joebmz98/FM-Drum-Machine/README.md

# FM-Drum-Machine
Teensy based frequency modulation drum machine. It uses the Audio Design tool to synthesize drum sounds and has a 16 step sequencer powered by an Arduino Nano.
