joebmz98/FM-Drum-Machine/docs/FM_DRUMMACHINE_LTSPICE/FM_DRUMMACHINE_COMPRESSOR_PEAKDETECTOR.asc

B1: bv; V=6 + 1.4*(time>0.05)*exp(-1*(time-0.05))*sin(2*pi*100*(time-0.05))
C1: EuropeanPolcap; 10µF
C2: cap; 10µF
C5: cap; 10µ; V=16 Irms=0 Rser=0.0038 Lser=877p mfg="Würth Elektronik" pn="885012108017 WCAP-CSGP 1206" type="X5R"
D7: diode; 1N4148
R1: res; 50k
R2: res; 500
R3: res; 50k
R4: res; 500
R6: res; 20k
R12: res; 1k
R13: res; 20k
R14: res; 80k
R15: res; 100k
R16: res; 100k
R17: res; 100k
R18: res; 100k
R19: res; 9k
R20: res; 1k
R21: res; 33k
R22: res; 470
R23: res; 4.7k
U1: UniversalOpAmp
U2: UniversalOpAmp
U6: UniversalOpAmp
U7: UniversalOpAmp
V1: signal; PWL file=decaying_sine_drum.txt
V3: voltage; 12V
Vref: voltage; 6
Named nets: 0
.tran 0 5s 0 100u
Vref
Vref
12V
THRESHOLD POT
.options pTranTau=0
PEAK DETECTOR
ATTACK POT
RATIO POT
REL POT
Vref
12V
Vref
