joebmz98/FM-Drum-Machine/docs/FM_DRUMMACHINE_LTSPICE/FM_DRUMMACHINE_COMPRESSOR.asc

B1: bv; V=6 + 1.4*(time>0.05)*exp(-1*(time-0.05))*sin(2*pi*100*(time-0.05))
C1: EuropeanPolcap; 10µF
C5: cap; 10µ; V=16 Irms=0 Rser=0.0038 Lser=877p mfg="Würth Elektronik" pn="885012108017 WCAP-CSGP 1206" type="X5R"
D1: diode; 1N4148
D2: diode; 1N4148
D3: diode; 1N4148
D4: diode; 1N4148
D5: diode; 1N4148
D6: diode; 1N4148
D7: diode; 1N4148
R1: res; 90k
R3: res; 10k
R4: res; 100K; tol=1 pwr=0.1
R5: res; 14k
R6: res; 20k
R7: res; 100k
R8: res; 100k
R9: res; 100k
R10: res; 100k
R11: res; 14k
R12: res; 1k
R13: res; 5k
R14: res; 80k
R15: res; 100k
R16: res; 100k
R17: res; 100k
R18: res; 100k
R19: res; 9k
R20: res; 1k
R21: res; 33k
R22: res; 470
R23: res; 4k7
U1: UniversalOpAmp
U2: UniversalOpAmp
U3: UniversalOpAmp
U4: UniversalOpAmp
U5: UniversalOpAmp
U6: UniversalOpAmp
U7: UniversalOpAmp
V1: signal; PWL file=decaying_sine_drum.txt
V3: voltage; 12V
Vref: voltage; 6
Named nets: 0
.tran 0 5s 0 100u
Vref
Vref
12V
THRESHOLD POT
.options pTranTau=0
PEAK DETECTOR
ATTACK POT
RATIO POT
REL POT
Vref
12V
Vref
