joebmz98/FM-Drum-Machine/build/FM_DRUM_MACHINE/FM_DRUM_MACHINE.kicad_pcb

## KiCad design build/FM_DRUM_MACHINE/FM_DRUM_MACHINE.kicad_pcb (2025-09-05)

Schematic: FM_DRUM_MACHINE.kicad_sch, FM Drum Machine

Parts:
A1, A2: GY-PCM5102; PCM5102_DAC_BreakoutBoard
C1, C2: 100uF; CP_Radial_D5.0mm_P2.00mm
C3, C4, C5, C6: 10uF; CP_Radial_D5.0mm_P2.00mm
C27, C43, C44, C45, C46, C47, C48, C49, C50, C51, C52, C53, C54, C55, C56, C57, C58, C59, C60, C61, C62, C63, C64, C75, C77, C79, C80: 10nF; C_Disc_P5.08mm
C69, C70, C71, C72, C73, C82: 10uF; C_Disc_P5.08mm
C74, C76, C78, C81: 1uF; C_Disc_P5.08mm
C83, C84, C85, C86, C87: 10Uf; C_Disc_P5.08mm
D1: 1N4148; D_4148_BigPads
D2: LED_STEP1; LED_D5.0mm
D3, D4: RED LED; LED_D5.0mm
D5, D6, D7, D8, D9, D10, D11, D12, D13, D14, D15, D16, D17, D18, D19, D20, D21, D22, D23, D24, D25, D26, D27, D28, D29, D63, D65, D66: 1N4148; D_DO-35_P7.62mm_Horizontal
D30: LED_STEP2; LED_D5.0mm
D31: LED_STEP3; LED_D5.0mm
D32: LED_STEP4; LED_D5.0mm
D33: LED_STEP5; LED_D5.0mm
D34: LED_STEP6; LED_D5.0mm
D35: LED_STEP7; LED_D5.0mm
D36: LED_STEP8; LED_D5.0mm
D37: LED_STEP9; LED_D5.0mm
D38: LED_STEP10; LED_D5.0mm
D39: LED_STEP11; LED_D5.0mm
D40: LED_STEP12; LED_D5.0mm
D41: LED_STEP13; LED_D5.0mm
D42: LED_STEP14; LED_D5.0mm
D43: LED_STEP15; LED_D5.0mm
D44: LED_STEP16; LED_D5.0mm
D45: LED_KICK; LED_D5.0mm
D46: LED_SNARE; LED_D5.0mm
D47: LED_CHAT; LED_D5.0mm
D48: LED_OHAT; LED_D5.0mm
D49: LED_LOTOM; LED_D5.0mm
D50: LED_HITOM; LED_D5.0mm
D51: LED_PLAY/TEMPO; LED_D5.0mm
D52: LED_RECORD; LED_D5.0mm
D53: LED_EXTCLK; LED_D5.0mm
D54: 1N914BWS; D_4148_BigPads; Part Number 1N914BWS; JLCPCB ID C258181
D57, D58, D59, D60, D61, D62, D67: 1N4148; D_DO-35_SOD27_P5.08mm_Vertical_KathodeUp
J1: PJ-102A; CUI_PJ-102A
J2: KICK_BUFFEREDOUT; Jack_3.5mm_CUI_SJ1-3525N_Horizontal_edit
J3: SNARE_BUFFEREDOUT; Jack_3.5mm_CUI_SJ1-3525N_Horizontal_edit
J4: HATS_BUFFEREDOUT; Jack_3.5mm_CUI_SJ1-3525N_Horizontal_edit
J5: TOMS_BUFFEREDOUT; Jack_3.5mm_CUI_SJ1-3525N_Horizontal_edit
J6: LINE_OUT; Jack_3.5mm_CUI_SJ1-3525N_Horizontal_edit
Nano1: Arduino Nano; Arduino_Nano
R1, R3, R5, R13: 820R; R_Axial_DIN0207_L6.3mm_D2.5mm_P7.62mm_Horizontal
R2, R4, R6, R14, R15, R50: 330R; R_Axial_DIN0207_L6.3mm_D2.5mm_P7.62mm_Horizontal
R7, R8, R9, R10, R92, R93, R94, R95: 220R; R_Axial_DIN0207_L6.3mm_D2.5mm_P7.62mm_Horizontal
R11, R57, R58, R63, R64, R65, R66, R67, R68, R69: 10k; R_Axial_DIN0207_L6.3mm_D2.5mm_P7.62mm_Horizontal
R12, R51: 22k; R_Axial_DIN0207_L6.3mm_D2.5mm_P7.62mm_Horizontal
R38, R39, R40, R41, R44, R45, R46, R54, R61, R70, R71, R75, R77, R78, R80, R81, R83, R84, R85, R86, R87: 100k; R_Axial_DIN0207_L6.3mm_D2.5mm_P7.62mm_Horizontal
R52: 680R; R_Axial_DIN0207_L6.3mm_D2.5mm_P7.62mm_Horizontal
R53, R56, R60, R73: 220k; R_Axial_DIN0207_L6.3mm_D2.5mm_P7.62mm_Horizontal
R55, R62, R88: 33k; R_Axial_DIN0207_L6.3mm_D2.5mm_P7.62mm_Horizontal
R59, R74: 1M; R_Axial_DIN0207_L6.3mm_D2.5mm_P7.62mm_Horizontal
R76, R79: 14k; R_Axial_DIN0207_L6.3mm_D2.5mm_P7.62mm_Horizontal
R82: 2k; R_Axial_DIN0207_L6.3mm_D2.5mm_P7.62mm_Horizontal
R89: 4k7; R_Axial_DIN0207_L6.3mm_D2.5mm_P7.62mm_Horizontal
R91: 100R; R_Axial_DIN0207_L6.3mm_D2.5mm_P7.62mm_Horizontal
RV1: KICK_DECAY; Potentiometer_RV09_BigPads
RV2: SWING; Potentiometer_RV09_BigPads
RV3: KICK_TUNE; Potentiometer_RV09_BigPads
RV4: KICK_PUNCH; Potentiometer_RV09_BigPads
RV5: KICK_ATTACK; Potentiometer_RV09_BigPads
RV6: SNARE_DECAY; Potentiometer_RV09_BigPads
RV7, RV9: SNARE_SNAP; Potentiometer_RV09_BigPads
RV8: SNARE_PITCH; Potentiometer_RV09_BigPads
RV10: SNARE_TONE; Potentiometer_RV09_BigPads
RV11: HAT_DECAY; Potentiometer_RV09_BigPads
RV12: HAT_TIMBRE; Potentiometer_RV09_BigPads
RV13: HAT_TONE; Potentiometer_RV09_BigPads
RV14: HAT_RESONANCE; Potentiometer_RV09_BigPads
RV15: LOTOM_DECAY; Potentiometer_RV09_BigPads
RV16: LOTOM_PUNCH; Potentiometer_RV09_BigPads
RV17: LOTOM_TUNE; Potentiometer_RV09_BigPads
RV18: LOTOM_ATTACK; Potentiometer_RV09_BigPads
RV19: HITOM_DECAY; Potentiometer_RV09_BigPads
RV20: HITOM_PUNCH; Potentiometer_RV09_BigPads
RV21: HITOM_TUNE; Potentiometer_RV09_BigPads
RV22: HITOM_ATTACK; Potentiometer_RV09_BigPads
RV27, RV28: 100k; Potentiometer_Alps_RK09L_Double_Vertical
RV29, RV32: 100k; Potentiometer_RV09_BigPads
RV30: A100k; Potentiometer_RV09_BigPads
RV31: 10k; Potentiometer_RV09_BigPads
RV33, RV35, RV40, RV46: B100k; Potentiometer_RV09_BigPads
RV37: TEMPO; Potentiometer_RV09_BigPads
RV38: B20k; Potentiometer_RV09_BigPads
RV39: A1k; Potentiometer_RV09_BigPads
SW1: STEP1; SW_Cherry_MX_PCB_1.00u
SW2: STEP2; SW_Cherry_MX_PCB_1.00u
SW3: STEP3; SW_Cherry_MX_PCB_1.00u
SW4: STEP4; SW_Cherry_MX_PCB_1.00u
SW5: STEP5; SW_Cherry_MX_PCB_1.00u
SW6: STEP6; SW_Cherry_MX_PCB_1.00u
SW7: STEP7; SW_Cherry_MX_PCB_1.00u
SW8: STEP8; SW_Cherry_MX_PCB_1.00u
SW9: STEP9; SW_Cherry_MX_PCB_1.00u
SW10: STEP10; SW_Cherry_MX_PCB_1.00u
SW11: STEP11; SW_Cherry_MX_PCB_1.00u
SW12: STEP12; SW_Cherry_MX_PCB_1.00u
SW13: STEP13; SW_Cherry_MX_PCB_1.00u
SW14: STEP14; SW_Cherry_MX_PCB_1.00u
SW15: STEP15; SW_Cherry_MX_PCB_1.00u
SW16: STEP16; SW_Cherry_MX_PCB_1.00u
SW17: KICK_TRIG; SW_Cherry_MX_PCB_1.00u
SW18: SNARE_TRIG; SW_Cherry_MX_PCB_1.00u
SW19: CHAT_TRIG; SW_Cherry_MX_PCB_1.00u
SW20: OHAT_TRIG; SW_Cherry_MX_PCB_1.00u
SW21: LOTOM_TRIG; SW_Cherry_MX_PCB_1.00u
SW22: HITOM_TRIG; SW_Cherry_MX_PCB_1.00u
SW23: PLAY/PAUSE; SW_Cherry_MX_PCB_1.00u
SW24: RECORD; SW_Cherry_MX_PCB_1.00u
SW25: SELECT; SW_Cherry_MX_PCB_1.00u
SW26, SW27: SW_DPDT_x2; Switch_Toggle_DPDT_SubMini
TRIM1, TRIM2, TRIM3: TrimPot_T73YEt_100k; Potentiometer_Bourns_3296W_Vertical_BigPads; Part Number T73YE104KT20
TRS_JACK_1: MIDI IN TYPE A; Jack_3.5mm_CUI_SJ1-3525N_Horizontal_edit
TRS_JACK_2: MIDI THRU TYPE A; Jack_3.5mm_CUI_SJ1-3525N_Horizontal_edit
TRS_JACK_3: MIDI OUT TYPE A; Jack_3.5mm_CUI_SJ1-3525N_Horizontal_edit
Teensy4.0: Teensy4.0; Teensy40
U1: 6N138; DIP-8_W7.62mm_LongPads
U2: TL072; DIP-8_W7.62mm_LongPads; JLCPCB ID C90748
U3, U12: OPA551P; DIP-8_W7.62mm
U4, U10, U11, U13, U14: TL074; DIP-14_W7.62mm_LongPads
U5: MAX7221xNG; DIP-24_W7.62mm
U6, U7: CD74HC4067M; SOIC-24W_7.5x15.4mm_P1.27mm
U8: AMS1117-5.0; SOT-223-3_TabPin2
U9: AMS1117-3.3; SOT-223-3_TabPin2

Connections:
3.3V: A1.6 (VIN), A1.13 (XSMT), A2.6 (VIN), A2.13 (XSMT), C72.2, RV1.3, RV3.3, RV4.3, RV5.3, RV6.3, RV7.3, RV8.3, RV9.3, RV10.3, RV11.3, RV12.3, RV13.3, RV14.3, RV15.3, RV16.3, RV17.3, RV18.3, RV19.3, RV20.3, RV21.3, RV22.3, U9.2 (VO)
5V: C70.2, C71.2, Nano1.30 (VIN), R8.2, R10.2, R11.2, RV2.3, RV37.3, Teensy4.0.33 (VIN), U1.8 (VCC), U5.19 (V+), U6.24 (VCC), U7.24 (VCC), U8.2 (VO), U9.3 (VI)
12V: C1.1, D54.2 (A), J1.2, J1.3, R70.1, R88.1, U2.8 (V+), U3.7 (V+), U4.4 (V+), U10.4 (V+), U11.4 (V+), U12.7 (V+), U13.4 (V+), U14.4 (V+)
A1BCK: A1.2 (BCK), A2.2 (BCK), Teensy4.0.28 (21_A7_RX5_BCLK1)
A1DIN: A1.3 (DIN), A2.3 (DIN), Teensy4.0.9 (7_RX2_OUT1A)
A1LCK: A1.4 (LCK), A2.4 (LCK), Teensy4.0.27 (20_A6_TX5_LRCLK1)
A1SCK: A1.1 (SCK), A2.1 (SCK), Teensy4.0.30 (23_A9_CRX1_MCLK1)
AGND: A1.8 (AGND), A1.10 (AGND), A2.8 (AGND), A2.10 (AGND)
CLK: Nano1.16 (D13), U5.13 (CLK)
COMPRESSOR_OUT: RV32.2, RV32.3, SW26.2 (B), U10.8
CS/LOAD: Nano1.13 (D10), U5.12 (~CS)
DGND: A1.5 (GND), A1.12 (FMT), A1.14 (DEMP), A1.15 (FLT), A2.5 (GND), A2.12 (FMT), A2.14 (DEMP), A2.15 (FLT), C2.2, C27.2, C43.2, C44.2, C45.2, C46.2, C47.2, C48.2, C49.2, C50.2, C51.2, C52.2, C53.2, C54.2, C55.2, C56.2, C57.2, C58.2, C59.2, C60.2, C61.2, C62.2, C63.2, C64.2, C69.1, C70.1, C71.1, C72.1, C73.1, J1.1, J2.S, J3.S, J4.S, J5.S, J6.S, Nano1.4 (GND), Nano1.29 (GND), R65.1, R66.1, R67.1, R68.1, R69.1, R71.2, RV1.1, RV2.1, RV3.1, RV4.1, RV5.1, RV6.1, RV7.1, RV8.1, RV9.1, RV10.1, RV11.1, RV12.1, RV13.1, RV14.1, RV15.1, RV16.1, RV17.1, RV18.1, RV19.1, RV20.1, RV21.1, RV22.1, RV33.1, RV35.1, RV37.1, RV39.1, RV40.1, RV46.1, TRS_JACK_1.S, TRS_JACK_2.S, TRS_JACK_3.S, Teensy4.0.1 (GND), Teensy4.0.32 (GND), U1.5 (GND), U2.4 (V-), U3.4 (V-), U3.8 (Flag), U4.11 (V-), U5.4 (GND), U5.9 (GND), U6.12 (GND), U6.15 (~E), U7.12 (GND), U7.15 (~E), U8.1 (GND), U9.1 (GND), U10.11 (V-), U11.11 (V-), U12.4 (V-), U12.8 (Flag), U13.11 (V-), U14.11 (V-)
DIG0: D2.1 (K), D34.1 (K), D39.1 (K), D44.1 (K), D49.1 (K), U5.2 (DIG_0)
DIG1: D30.1 (K), D35.1 (K), D40.1 (K), D45.1 (K), D50.1 (K), U5.11 (DIG_1)
DIG2: D31.1 (K), D36.1 (K), D41.1 (K), D46.1 (K), D51.1 (K), U5.6 (DIG_2)
DIG3: D32.1 (K), D37.1 (K), D42.1 (K), D47.1 (K), D52.1 (K), U5.7 (DIG_3)
DIG4: D33.1 (K), D38.1 (K), D43.1 (K), D48.1 (K), D53.1 (K), U5.3 (DIG_4)
DIN: Nano1.14 (D11), U5.1 (DIN)
HATSBUFFER_IN: C5.1, R4.2, R40.1, U14.10 (+)
HATS_DCBIAS_IN: C5.2, RV33.3
HATS_OUT: A2.7 (LOUT), RV33.2
HAT_DECAY: C53.1, RV11.2, U6.22 (I9)
HAT_RESONANCE: C56.1, RV14.2, U6.19 (I12)
HAT_TIMBRE: C54.1, RV12.2, U6.20 (I11)
HAT_TONE: C55.1, RV13.2, U6.21 (I10)
HITOM_ATTACK: C64.1, RV22.2, U7.2 (I7)
HITOM_DECAY: C61.1, RV19.2, U7.5 (I4)
HITOM_PITCH: C63.1, RV21.2, U7.4 (I5)
HITOM_PUNCH: C62.1, RV20.2, U7.3 (I6)
HPFSTAGE_OUT: R59.1, SW26.5 (B), SW27.2 (B)
HPF_IN: C74.1, SW26.3 (C)
HPF_OUT: C76.2, R56.1, SW26.6 (C)
KICKBUFFER_IN: C3.1, R38.1, R50.2, U14.3 (+)
KICK_ATTACK: C47.1, RV5.2, U6.6 (I3)
KICK_DCBIAS_IN: C3.2, RV46.3
KICK_DECAY: C44.1, RV1.2, U6.9 (I0)
KICK_OUT: A1.7 (LOUT), RV46.2
KICK_PUNCH: C46.1, RV4.2, U6.7 (I2)
KICK_TUNE: C45.1, RV3.2, U6.8 (I1)
LOTOM_ATTACK: C60.1, RV18.2, U7.6 (I3)
LOTOM_DECAY: C57.1, RV15.2, U7.9 (I0)
LOTOM_PUNCH: C58.1, RV16.2, U7.7 (I2)
LOTOM_TUNE: C59.1, RV17.2, U7.8 (I1)
LPFSTAGE_OUT: R74.1, SW27.5 (B), U13.12 (+)
LPF_IN: C78.1, SW27.3 (C)
LPF_OUT: C81.2, R73.1, SW27.6 (C)
MIDI IN: Nano1.2 (D0/RX), R8.1, U1.6 (VO2)
MIDI OUT: Nano1.1 (D1/TX), R9.2, Teensy4.0.2 (0_RX1_CRX2_CS1)
MIXER_OUT: R46.2, R75.1, U2.1
unnamed: C74.2, R53.1, R54.1
unnamed: C77.1, R57.1, U4.14
unnamed: C78.2, R60.1, R61.1
unnamed: C79.1, R63.1, U11.14
unnamed: C83.2, RV39.2
unnamed: C84.2, R92.2
unnamed: C85.2, R93.2
unnamed: C86.2, R94.2
unnamed: C87.2, R95.2
unnamed: D1.2 (A), TRS_JACK_1.T, TRS_JACK_2.T, U1.3 (C2)
unnamed: D1.1 (K), R7.1, U1.2 (C1)
unnamed: D3.1 (K), D4.2 (A), R51.2, R52.2, U13.13 (-)
unnamed: D5.2 (A), SW1.2
unnamed: D6.2 (A), SW2.2
unnamed: D7.2 (A), SW3.2
unnamed: D8.2 (A), SW4.2
unnamed: D9.2 (A), SW5.2
unnamed: D10.2 (A), SW6.2
unnamed: D11.2 (A), SW7.2
unnamed: D12.2 (A), SW8.2
unnamed: D13.2 (A), SW9.2
unnamed: D14.2 (A), SW10.2
unnamed: D15.2 (A), SW11.2
unnamed: D16.2 (A), SW12.2
unnamed: D17.2 (A), SW13.2
unnamed: D18.2 (A), SW14.2
unnamed: D19.2 (A), SW15.2
unnamed: D20.2 (A), SW16.2
unnamed: D21.2 (A), SW17.2
unnamed: D22.2 (A), SW18.2
unnamed: D23.2 (A), SW19.2
unnamed: D24.2 (A), SW20.2
unnamed: D25.2 (A), SW21.2
unnamed: D26.2 (A), SW22.2
unnamed: D27.2 (A), SW23.2
unnamed: D28.2 (A), SW24.2
unnamed: D29.2 (A), SW25.2
unnamed: C69.2, D54.1 (K), U8.3 (VI)
unnamed: D57.2 (A), D58.1 (K)
unnamed: D57.1 (K), D60.2 (A), R77.2, U10.12 (+)
unnamed: D58.2 (A), D59.1 (K)
unnamed: D59.2 (A), R81.1, R82.2
unnamed: D60.1 (K), D61.2 (A)
unnamed: D61.1 (K), D62.2 (A)
unnamed: D62.1 (K), R80.2, U10.7
unnamed 94: D63.2 (A), D65.1 (K); also elsewhere on the board
unnamed: D63.1 (K), D66.2 (A), R83.2, U13.9 (-)
unnamed: D65.2 (A), D66.1 (K), R82.1, U13.8
unnamed: D67.2 (A), U13.1
unnamed 99: D67.1 (K), TRIM2.3 (Right); also elsewhere on the board
unnamed: J2.T, R92.1
unnamed: J3.T, R93.1
unnamed: J4.T, R94.1
unnamed: J5.T, R95.1
unnamed: J6.T, R91.1
unnamed: R1.2, RV28.1
unnamed: R5.1, RV27.1
unnamed: R7.2, TRS_JACK_1.R, TRS_JACK_2.R
unnamed: R9.1, TRS_JACK_3.T
unnamed: R10.1, TRS_JACK_3.R
unnamed: R14.2, RV29.1
unnamed: R44.2, R45.1, U2.7
unnamed: R52.1, RV38.1, RV38.2
unnamed: R84.2, RV30.1, U13.7
unnamed: R85.1, RV31.2
unnamed: R88.2, RV31.3
unnamed: R91.2, RV39.3
unnamed: SW26.1 (A), SW26.4 (A)
unnamed: SW27.1 (A), SW27.4 (A)
unnamed: TRIM1.2 (Center), U4.12 (+)
unnamed: R15.2, TRIM1.1 (Left)
unnamed: C76.1, TRIM1.3 (Right), U4.8, U4.9 (-)
unnamed 122: C82.2, R86.1, TRIM2.1 (Left), TRIM2.2 (Center), TRIM3.3 (Right), U13.2 (-); also elsewhere on the board
unnamed 123: R89.2, TRIM3.1 (Left), TRIM3.2 (Center); also elsewhere on the board
unnamed: R45.2, R46.1, U2.2 (-)
unnamed: R38.2, R39.2, R40.2, R41.2, R44.1, U2.6 (-)
unnamed: C73.2, R70.2, R71.1, U3.3 (+)
unnamed: R54.2, R55.2, U4.3 (+)
unnamed: C75.1, U4.1, U4.2 (-)
unnamed: C77.2, RV27.2, RV27.3, U4.5 (+)
unnamed: R13.1, R13.2, RV27.4, U4.6 (-), U4.7
unnamed: C75.2, RV27.5, RV27.6, U4.10 (+)
unnamed: R57.2, R58.1, U4.13 (-)
unnamed: R11.1, U5.18 (ISET)
unnamed: R75.2, R76.2, U10.3 (+)
unnamed: R77.1, U10.1, U10.2 (-)
unnamed: R80.1, R81.2, U10.6 (-)
unnamed: R78.2, U10.10 (+), U10.14, U13.3 (+)
unnamed: R12.2, RV32.1, U10.9 (-)
unnamed: R78.1, R79.2, U10.13 (-)
unnamed: R61.2, R62.2, U11.3 (+)
unnamed: R1.1, U11.1, U11.2 (-)
unnamed: C79.2, RV28.2, RV28.3, U11.5 (+)
unnamed: R3.1, R3.2, RV28.4, U11.6 (-), U11.7
unnamed: C80.2, RV28.5, RV28.6, U11.10 (+)
unnamed: C81.1, RV29.3, U11.8, U11.9 (-)
unnamed: RV29.2, U11.12 (+)
unnamed: R63.2, R64.1, U11.13 (-)
unnamed: C1.2, C2.1, U3.2 (-), U3.6, U12.3 (+)
unnamed: R86.2, R87.2, U13.5 (+)
unnamed: R84.1, R85.2, U13.6 (-)
unnamed: RV30.2, U13.10 (+)
unnamed: C84.1, U14.1, U14.2 (-)
unnamed: C85.1, U14.6 (-), U14.7
unnamed: C86.1, U14.8, U14.9 (-)
unnamed: C87.1, U14.13 (-), U14.14
SEGA: D2.2 (A), D30.2 (A), D31.2 (A), D32.2 (A), D33.2 (A), U5.14 (SEG_A)
SEGB: D34.2 (A), D35.2 (A), D36.2 (A), D37.2 (A), D38.2 (A), U5.16 (SEG_B)
SEGC: D39.2 (A), D40.2 (A), D41.2 (A), D42.2 (A), D43.2 (A), U5.20 (SEG_C)
SEGD: D44.2 (A), D45.2 (A), D46.2 (A), D47.2 (A), D48.2 (A), U5.23 (SEG_D)
SEGE: D49.2 (A), D50.2 (A), D51.2 (A), D52.2 (A), D53.2 (A), U5.21 (SEG_E)
SNAREBUFFER_IN: C4.1, R2.2, R39.1, U14.5 (+)
SNARE_DCBIAS_IN: RV40.3
SNARE_DECAY: C48.1, RV6.2, U6.5 (I4)
SNARE_OUT: A1.9 (ROUT), RV40.2
SNARE_PITCH: C50.1, RV8.2, U6.4 (I5)
SNARE_PUNCH: C49.1, RV7.2, U6.3 (I6)
SNARE_SNAP: C51.1, RV9.2, U6.2 (I7)
SNARE_TONE: C52.1, RV10.2, U6.23 (I8)
SOFTCLIP_OUT: C83.1, D3.2 (A), D4.1 (K), R51.1, U13.14
SWING: C43.1, Nano1.25 (A6), RV2.2
TEMPO: C27.1, Nano1.24 (A5), RV37.2
TOMSBUFFER_IN: C6.1, R6.2, R41.1, U14.12 (+)
TOMS_DCBIAS_IN: C6.2, RV35.3
TOMS_OUT: A2.9 (ROUT), RV35.2
U6S0: Teensy4.0.11 (9_OUT1C), U6.10 (S0)
U6S1: Teensy4.0.12 (10_CS_MQSR), U6.11 (S1)
U6S2: Teensy4.0.13 (11_MOSI_CTX1), U6.14 (S2)
U6S3: Teensy4.0.14 (12_MISO_MQSL), U6.13 (S3)
U6SIG: Teensy4.0.21 (14_A0_TX3_SPDIF_OUT), U6.1 (COM)
U7S0: Teensy4.0.23 (16_A2_RX4_SCL1), U7.10 (S0)
U7S1: Teensy4.0.24 (17_A3_TX4_SDA1), U7.11 (S1)
U7S2: Teensy4.0.25 (18_A4_SDA0), U7.14 (S2)
U7S3: Teensy4.0.26 (19_A5_SCL0), U7.13 (S3)
U7SIG: Teensy4.0.22 (15_A1_RX3_SPDIF_IN), U7.1 (COM)
Vref: C80.1, C82.1, R2.1, R4.1, R5.2, R6.1, R12.1, R14.1, R15.1, R50.1, R53.2, R55.1, R56.2, R58.2, R59.2, R60.2, R62.1, R64.2, R73.2, R74.2, R76.1, R79.1, R83.1, R87.1, R89.1, RV30.3, RV31.1, RV38.3, U2.3 (+), U2.5 (+), U10.5 (+), U12.2 (-), U12.6
X0: Nano1.19 (A0), R65.2, SW1.1, SW6.1, SW11.1, SW16.1, SW21.1
X1: Nano1.20 (A1), R66.2, SW2.1, SW7.1, SW12.1, SW17.1, SW22.1
X2: Nano1.21 (A2), R67.2, SW3.1, SW8.1, SW13.1, SW18.1, SW23.1
X3: Nano1.22 (A3), R68.2, SW4.1, SW9.1, SW14.1, SW19.1, SW24.1
X4: Nano1.23 (A4), R69.2, SW5.1, SW10.1, SW15.1, SW20.1, SW25.1
Y0: D5.1 (K), D6.1 (K), D7.1 (K), D8.1 (K), D9.1 (K), Nano1.5 (D2)
Y1: D10.1 (K), D11.1 (K), D12.1 (K), D13.1 (K), D14.1 (K), Nano1.6 (D3)
Y2: D15.1 (K), D16.1 (K), D17.1 (K), D18.1 (K), D19.1 (K), Nano1.7 (D4)
Y3: D20.1 (K), D21.1 (K), D22.1 (K), D23.1 (K), D24.1 (K), Nano1.8 (D5)
Y4: D25.1 (K), D26.1 (K), D27.1 (K), D28.1 (K), D29.1 (K), Nano1.9 (D6)

Notes on the sheet:
MORITZ KLEIN LPF
INPUT POWER
RATIO
FILTER STAGE
LO TOM
GAIN
DIGITAL SECTION
MIDI OUTPUT STAGE
DIFFERENTIAL MIXER
CUT-OFF DUAL POT
LPF W/ RESONANCE
RELEASE
PASSIVE ATTENUATORS
RESONANCE TRIM POT
DRIVE
ANALOGUE SECTION
MAX7219
MIDI INPUT STAGE
SOFT CLIP STAGE
LEVEL POTS
HI TOM
SEQUENCER BUTTON MTRX
FM DRUMS
MASTER OUTPUT STAGE
POWER SECTION
MORITZ KLEIN COMPRESSOR
MORITZ KLEIN HPF
TEENSY
KICK
SEQUENCER_POTS
MIXER STAGE
HPF SEMI-RESONANT
SEQUENCER PROCESSOR
MASTER VOLUME
LEDS
SEQUENCER LED MTRX
DC BIASING
DACS
VIRTUAL RAILS
THRESHOLD
SEQUENCER
HAT
DRUM VOICE BUFFERED OUTPUTS
ATTACK
RESONANCE
COMPRESSOR STAGE
MULTIPLEXERS
SNARE

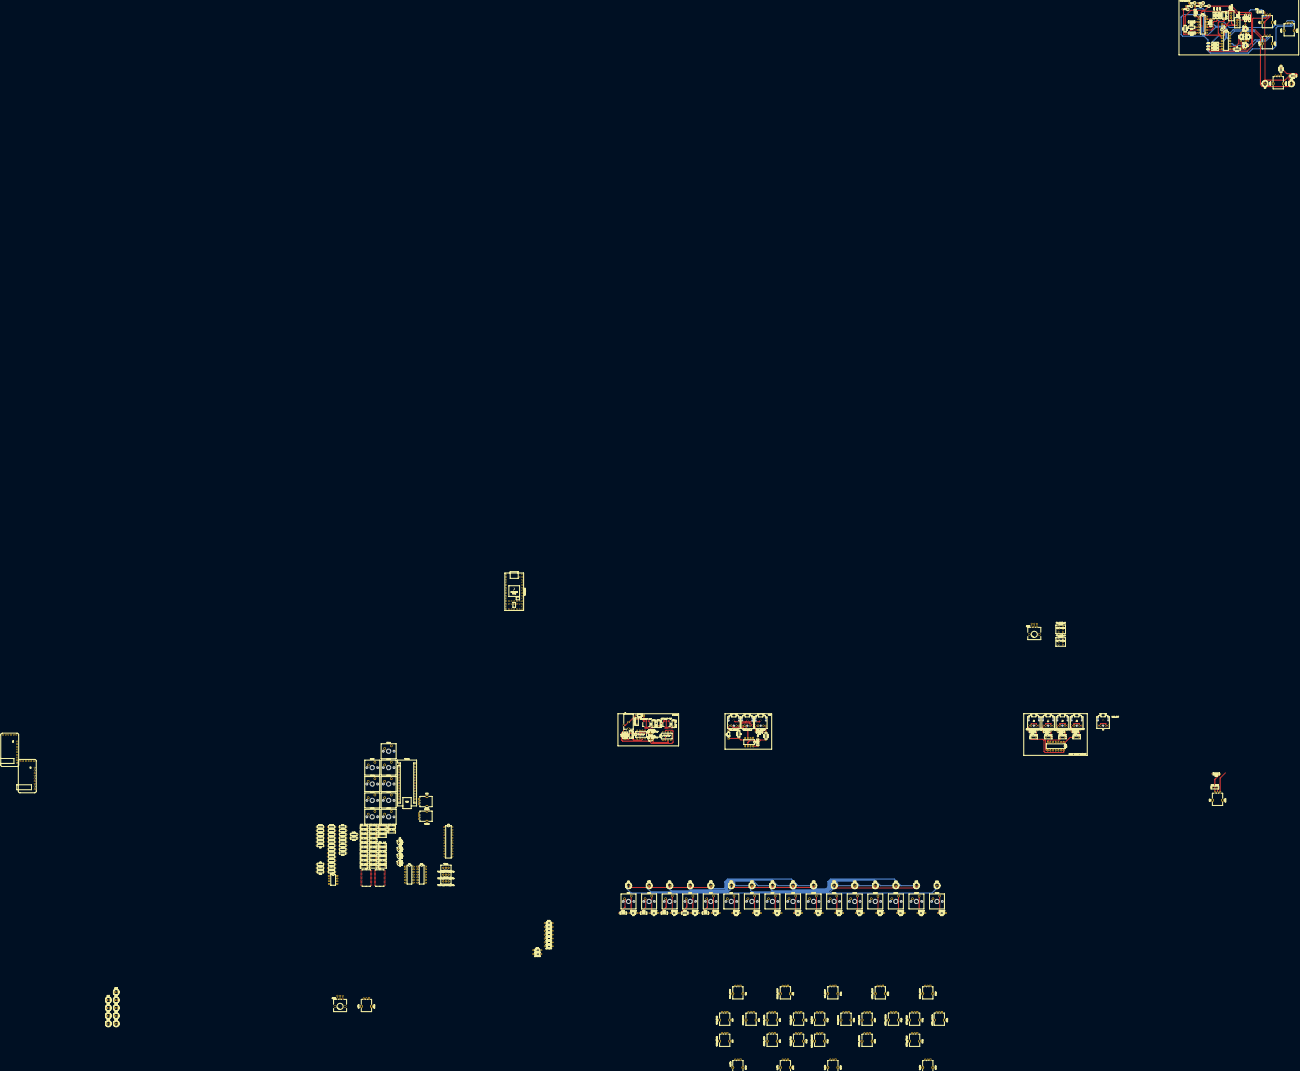
[picture p1: board FM_DRUM_MACHINE.kicad_pcb from above]

Board: 2 copper layers, 273 parts (0 on the bottom side), 194 nets.

Other parts of the board:
ATTACK: 100k; Potentiometer_Bourns_3296W_Vertical_BigPads
D64: 1N4148; D_DO-35_P7.62mm_Horizontal
RELEASE: 100k; Potentiometer_Bourns_3296W_Vertical_BigPads

Their connections:
unnamed 94: D64.1 (K); also elsewhere on the board
unnamed 99: ATTACK.3 (Right); also elsewhere on the board
unnamed 122: ATTACK.1 (Left), ATTACK.2 (Center), RELEASE.3 (Right); also elsewhere on the board
unnamed 123: RELEASE.1 (Left), RELEASE.2 (Center); also elsewhere on the board
