joebmz98/FM-Drum-Machine/build/FM_DRUM_MACHINE/FM_DRUM_MACHINE_POWERIN/FM_DRUM_MACHINE_POWERIN.kicad_pcb

## KiCad design build/FM_DRUM_MACHINE/FM_DRUM_MACHINE_POWERIN/FM_DRUM_MACHINE_POWERIN.kicad_pcb (2025-08-22)

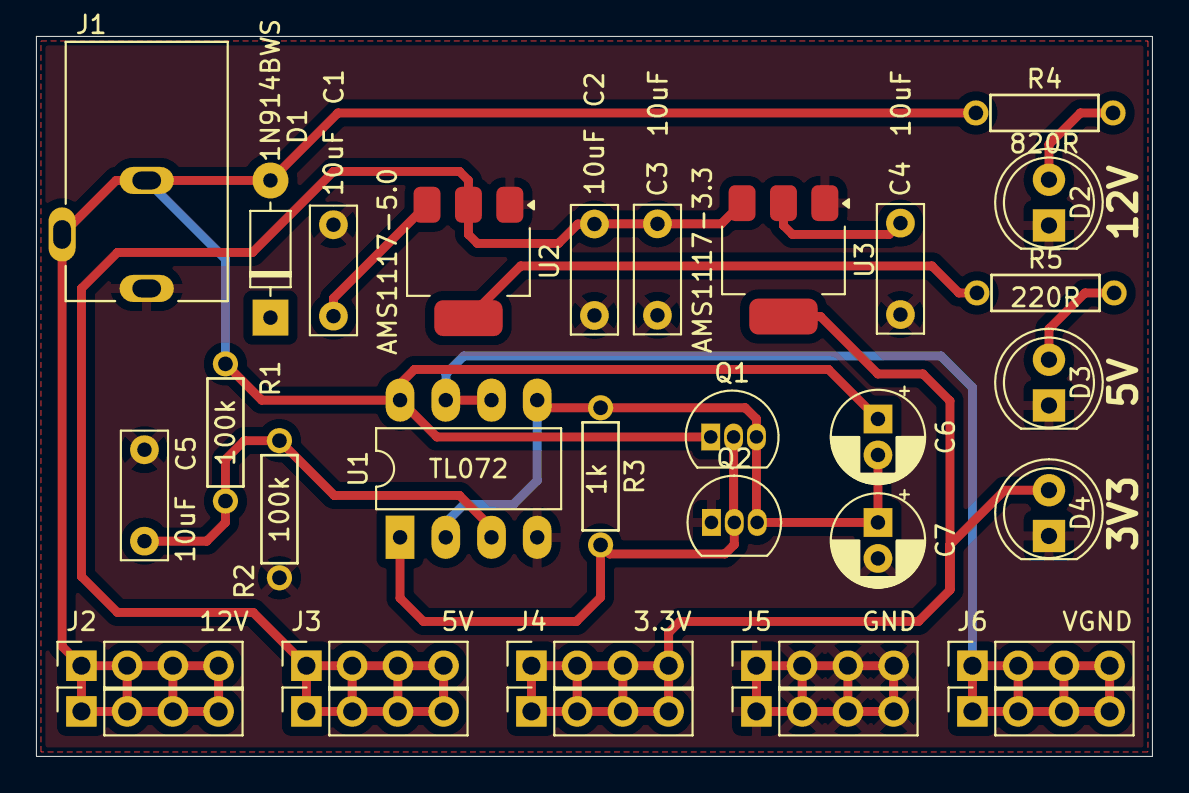
[picture p2: board FM_DRUM_MACHINE_POWERIN.kicad_pcb from above]

Board: 2 copper layers, 62.0 x 40.0 mm, 32 parts (0 on the bottom side), 11 nets.

Parts:
C1, C2, C3, C4, C5: 10uF; C_Disc_P5.08mm
C6, C7: 100uF; CP_Radial_D5.0mm_P2.00mm
D1: 1N914BWS; D_4148_BigPads
D2, D3, D4: LED; LED_D5.0mm
J1: PJ-102A; CUI_PJ-102A
J2, J2#2: 12V; PinSocket_1x04_P2.54mm_Vertical
J3, J3#2: 5V; PinSocket_1x04_P2.54mm_Vertical
J4, J4#2: 3.3V; PinSocket_1x04_P2.54mm_Vertical
J5, J5#2: GND; PinSocket_1x04_P2.54mm_Vertical
J6, J6#2: VGND; PinSocket_1x04_P2.54mm_Vertical
Q1: BC547; TO-92L_Inline
Q2: BC557; TO-92_Inline
R1, R2: 100k; R_Axial_DIN0207_L6.3mm_D2.5mm_P7.62mm_Horizontal
R3: 1k; R_Axial_DIN0207_L6.3mm_D2.5mm_P7.62mm_Horizontal
R4: 820R; R_Axial_DIN0207_L6.3mm_D2.5mm_P7.62mm_Horizontal
R5: 220R; R_Axial_DIN0207_L6.3mm_D2.5mm_P7.62mm_Horizontal
U1: TL072; DIP-8_W7.62mm_LongPads
U2: AMS1117-5.0; SOT-223-3_TabPin2
U3: AMS1117-3.3; SOT-223-3_TabPin2

Connections:
3.3V: C4.2, D4.2 (A), J4.1, J4.2, J4.3, J4.4, J4#2.1, J4#2.2, J4#2.3, J4#2.4, U3.2 (VO)
5V: C2.2, C3.2, J3.1, J3.2, J3.3, J3.4, J3#2.1, J3#2.2, J3#2.3, J3#2.4, R5.2, U2.2 (VO), U3.3 (VI)
12V: C6.1, D1.2 (A), J1.2, J1.3, J2.1, J2.2, J2.3, J2.4, J2#2.1, J2#2.2, J2#2.3, J2#2.4, Q1.1 (C), R1.1, R4.2, U1.8 (V+)
GND: C1.1, C2.1, C3.1, C4.1, C5.1, C7.2, D2.1 (K), D3.1 (K), D4.1 (K), J1.1, J5.1, J5.2, J5.3, J5.4, J5#2.1, J5#2.2, J5#2.3, J5#2.4, Q2.1 (C), R2.2, U1.4 (V-), U2.1 (GND), U3.1 (GND)
unnamed: C1.2, D1.1 (K), U2.3 (VI)
unnamed: D2.2 (A), R4.1
unnamed: D3.2 (A), R5.1
unnamed: Q1.2 (B), Q2.2 (B), R3.1, U1.1
unnamed: C6.2, C7.1, Q1.3 (E), Q2.3 (E), R3.2, U1.2 (-), U1.5 (+)
unnamed: C5.2, R1.2, R2.1, U1.3 (+)
VGND: J6.1, J6.2, J6.3, J6.4, J6#2.1, J6#2.2, J6#2.3, J6#2.4, U1.6 (-), U1.7
