joebmz98/FM-Drum-Machine/(commit log)

2025-08-20 v0.1.0
    - Initial Schematic Push
    [FM_DRUM_MACHINE.kicad_pcb, FM_DRUM_MACHINE.kicad_sch]
2025-08-21 v0.2
    - Further Schematic Modifications
    [FM_DRUM_MACHINE.kicad_sch]
2025-08-21 v0.3
    - Circuit schematic update
    [FM_DRUM_MACHINE.kicad_sch]
2025-08-21 v0.4.0
    - Modified mixer stage. Passive attenuators before DC bias to use the Differential Amplifier as a mixer.
    [FM_DRUM_MACHINE.kicad_sch]
2025-08-22 v0.5
    POWER IN BOARD
    [FM_DRUM_MACHINE.kicad_pcb, FM_DRUM_MACHINE.kicad_sch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]
2025-08-23 v0.5.5
    - Drive section modified based on testing
    - LPF/HPF Based on testing
    [FM_DRUM_MACHINE.kicad_pcb, FM_DRUM_MACHINE.kicad_sch]
2025-08-31 Sound Design Edits
    [FM_DRUM_MACHINE.kicad_sch]
2025-09-01 Schematic Changes
    [FM_DRUM_MACHINE.kicad_sch]
2025-09-01 FM_HATS Prototype Voice
2025-09-01 Hi Hats added to ENGINE
    [FM_DRUM_MACHINE.kicad_sch]
2025-09-02 Prototype Tom Voices
    - Added prototype tom voices
    - Removed pitch envelope control from the kick
2025-09-02 Ground Loop Isolation
    - Filtered +12V to help with noise. This also filters the Vref rail
    - Separated. the DGND from AGND
    [FM_DRUM_MACHINE.kicad_sch]
2025-09-02 Ground Isolation
    [FM_DRUM_MACHINE.kicad_sch]
2025-09-03 PCB Changes
    [FM_DRUM_MACHINE.kicad_pcb, FM_DRUM_MACHINE.kicad_sch]
2025-09-03 compressor edits
    [FM_DRUM_MACHINE.kicad_sch]
2025-09-05 LT_SPICE SImulations
    [FM_DRUM_MACHINE.kicad_sch]
2025-09-05 Schematic PCB Changes
    - Updated Power In
    - Updated PCB
    [FM_DRUM_MACHINE.kicad_pcb, FM_DRUM_MACHINE.kicad_sch]
